Jetblack31/MaxPV/SchemasMaxPV/Schémas MAXPV 10x10 V2/Schema_ECOPV_10x10 V2_Logique.png

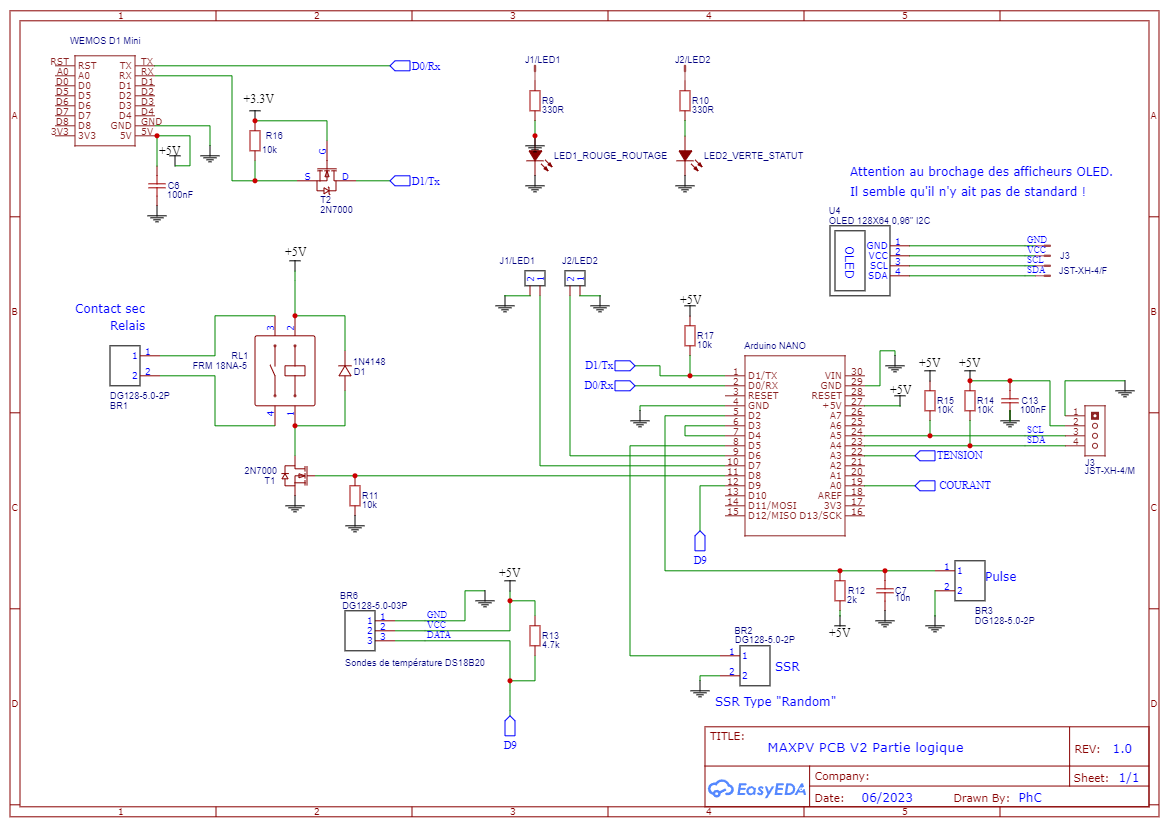
SchemasMaxPV/Schémas MAXPV 10x10 V2/Schema_ECOPV_10x10 V2_Logique.png
