Jetblack31/MaxPV/SchemasMaxPV/Schémas MAXPV 10x10 V2/Schematic_ECOPV_10x10 V2_Analogique.png

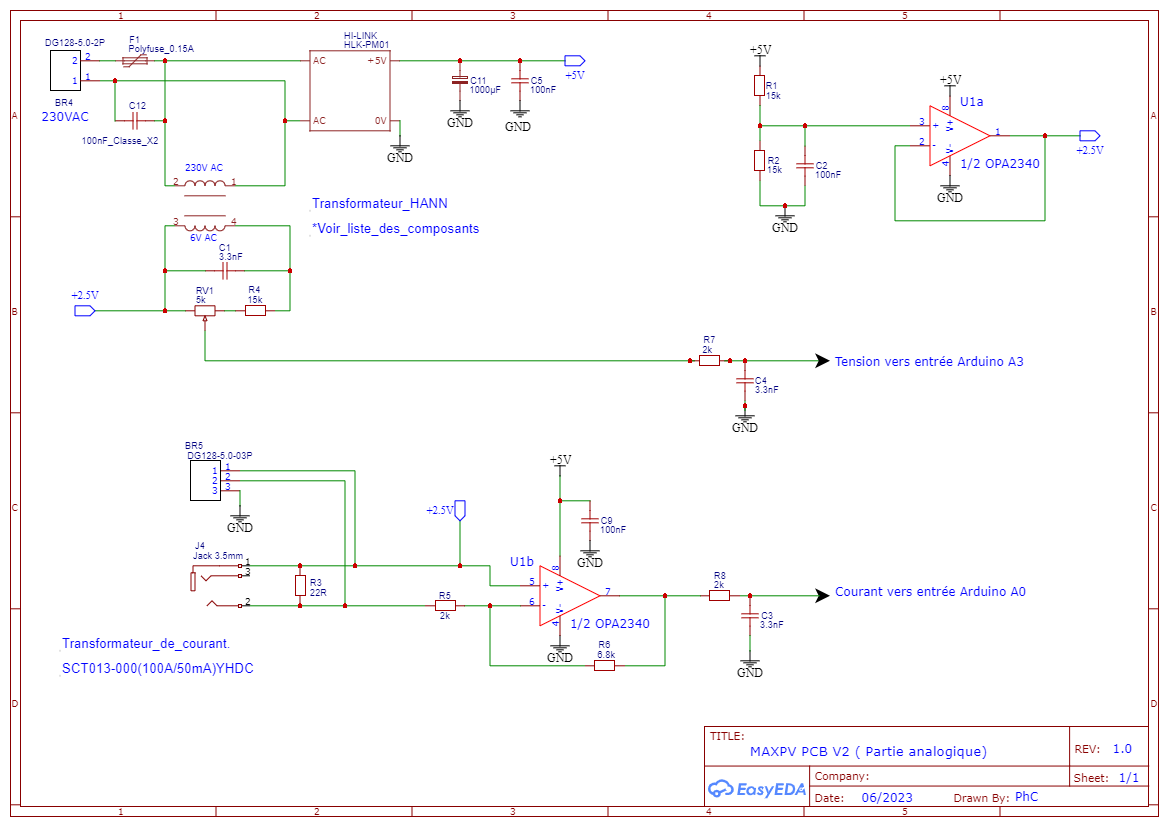
SchemasMaxPV/Schémas MAXPV 10x10 V2/Schematic_ECOPV_10x10 V2_Analogique.png
