Jetblack31/MaxPV/SchemasMaxPV/Schémas MaxPV DIN V2.2/Schema_MAXPV_DIN_Logique_V2.2.png

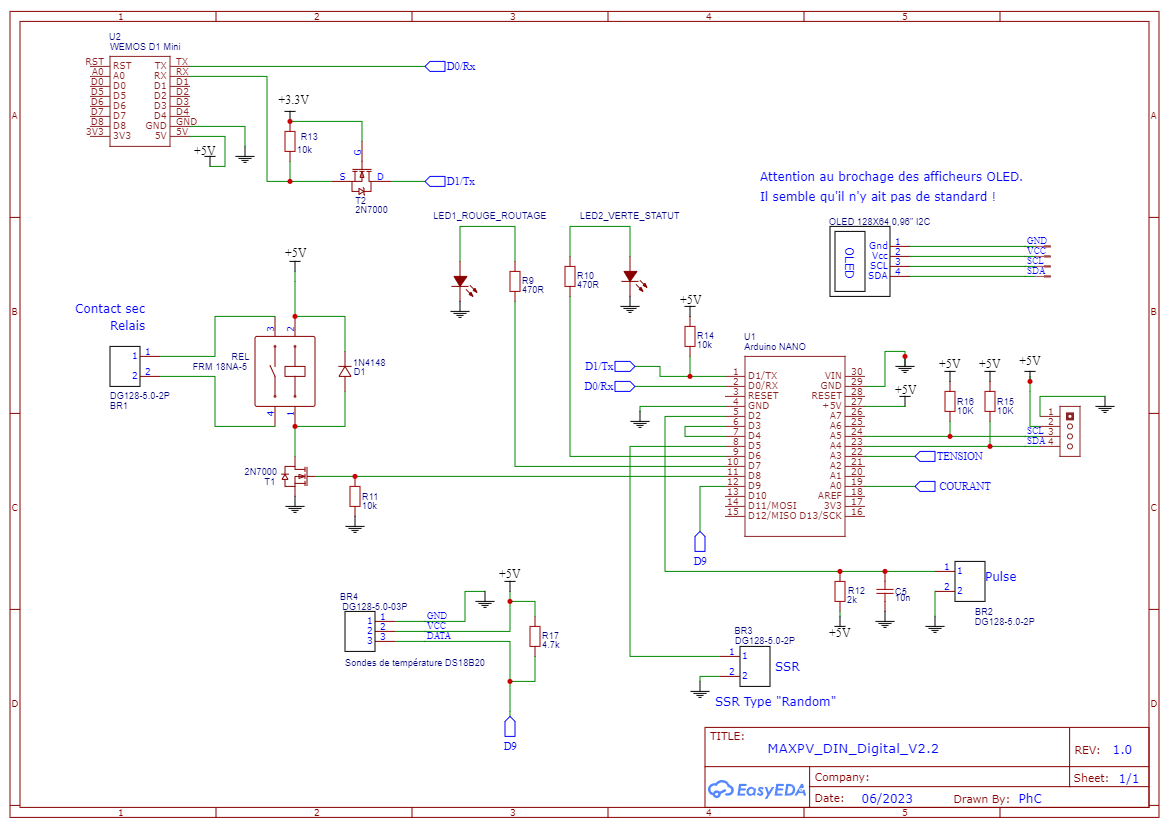
SchemasMaxPV/Schémas MaxPV DIN V2.2/Schema_MAXPV_DIN_Logique_V2.2.png
