Jetblack31/MaxPV/SchemasMaxPV/Schémas MaxPV DIN V2.2/Schematic_MAXPV_DIN_Analogique_V2_2023-07-07.png

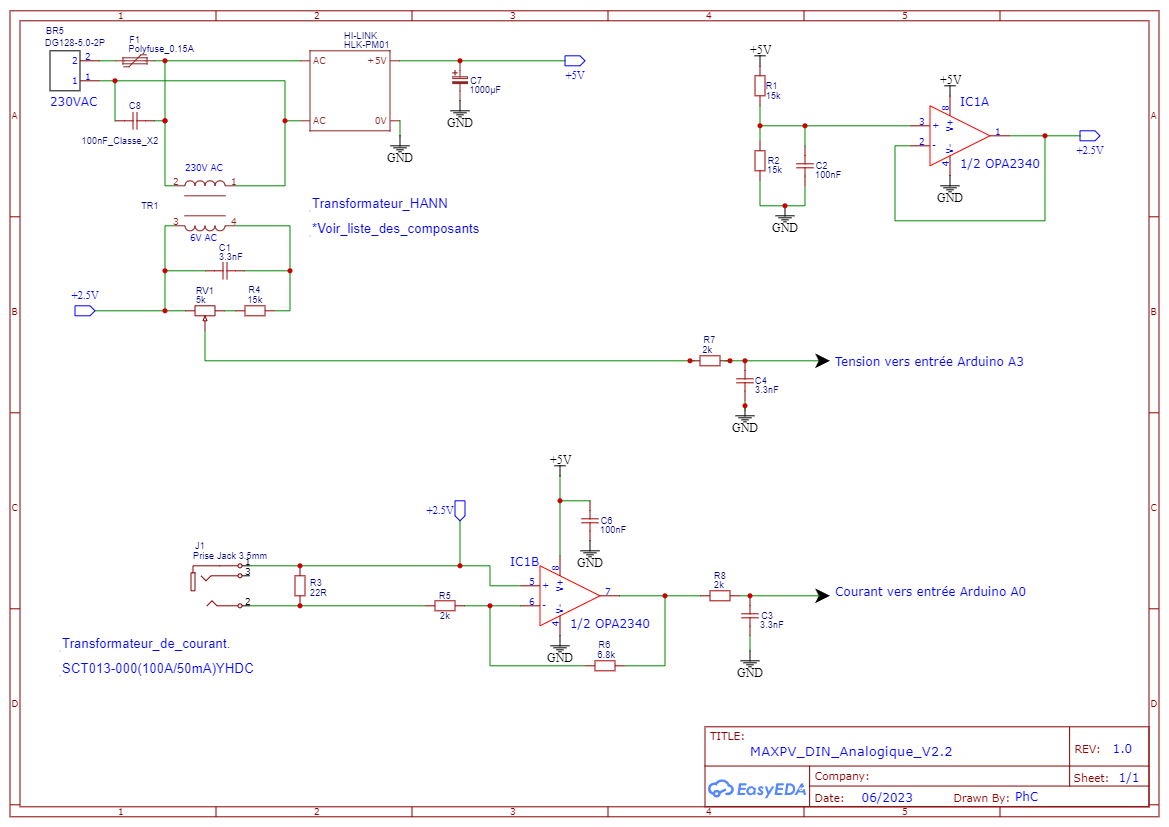
SchemasMaxPV/Schémas MaxPV DIN V2.2/Schematic_MAXPV_DIN_Analogique_V2_2023-07-07.png
