Jetblack31/MaxPV/(threads)

Thread 11 (2022-12-14):

Eviter l'activation du SSR par inadvertance

yoyolb, 2022-12-14:
Bonjour,

La page "Moniteur" présente des données de supervision ("Valeurs courantes") et permet également d'agir sur l'état du routeur (activation/désactivation du mode BOOST, activation du SSR, activation du relais).

Ces fonctionnalités sont très utiles mais il m'est arrivé à plusieurs reprises, en particulier sur un téléphone portable, de mettre en marche forcée le SSR par inadvertance en voulant seulement consulter les données de supervision.

Je pense qu'il serait judicieux de ce prémunir contre ces erreurs de manips:
- soit en séparant les données de supervision des actions de modification
- soit en ajoutant un popup de confirmation
- soit en ajoutant un mode "modification" versus "lecture seule" sur la page
- ... sans doute d'autres moyens ...

En tout cas merci pour le travail déjà réalisé, bravo !

Jetblack31, 2022-12-21:
Bonjour,

Merci pour le retour. Je vois comment modifier la présentation dans la nouvelle version pour régler ce problème.

Jetblack

Thread 13 (2023-01-19):

Comptabilisation routage en mode forcé

Stabu1, 2023-01-19:
Bonjour
Tout d’abord un grand bravo pour le travail formidable. Depuis la v3.5 la comptabilisation de la puissance routé inclue    la puissance consommée en mode forcé ce qui n’est pas logique. En version 3.35 ce n’était pas le cas, en mode forcé la nuit on ne peut pas considérer et comptabiliser un routage. Merci.

Jetblack31, 2023-01-19:
Bonsoir,

Merci pour le retour !
L'accumulation de l'énergie routée en mode FORCE ou BOOST était une demande de certains utilisateurs pour que le compteur d'énergie routée devienne un compteur d'énergie de production d'eau chaude.
D'où la modification en version 3.5.
Si vous voulez revenir au comportement initial, modifiez la ligne 690 du programme EcoPV en :

if ( triacMode == 9) routedEnergy += Prouted;

et uploadez le nano avec ce programme modifié.

Jetblack

Stabu1, 2023-01-20:
Merci pour la réponse et réactivité !
Je ferme l'issue.

Jetblack31, 2023-01-20:
Pour utiliser le #define du code, il serait plus "propre" d'utiliser

`if ( triacMode == AUTOM ) routedEnergy += Prouted;
`

Closed 2023-01-20.

Thread 22 (2024-04-03):

Ajout d'un minTemp ?

gmella, 2024-04-03:
Rajouter un **minTemp** pourrait permettre un fonctionnement autonome y compris en cas de mauvais temps prolongé ... du coup parfait pour l'hiver.
L'idéal étant de pouvoir monter un peu cette consigne lors des HC pour optimiser encore un peu, mais c'est moins important si l'installation est souvent en injection.

Merci pour ce superbe projet !

Thread 23 (2025-05-12):

Limite température basse CE et sortie contact sec ou boost

Mustang5705, 2025-05-12:
Bonjour,
Serait-il possible de déclencher le contact sec ou le mode boost sur une limite de température basse pour compléter le chauffage du CE dans la période HC (ou à définir) si les PV n'ont pas permis de chauffer suffisamment ?
Merci.
