Jetblack31/MaxPV/SchemasMaxPV/Schémas MaxPV DIN V2.2/Schematic_MAXPV_DIN_Analogique_V2_2023-07-07.pdf

## Transformateur_HANN

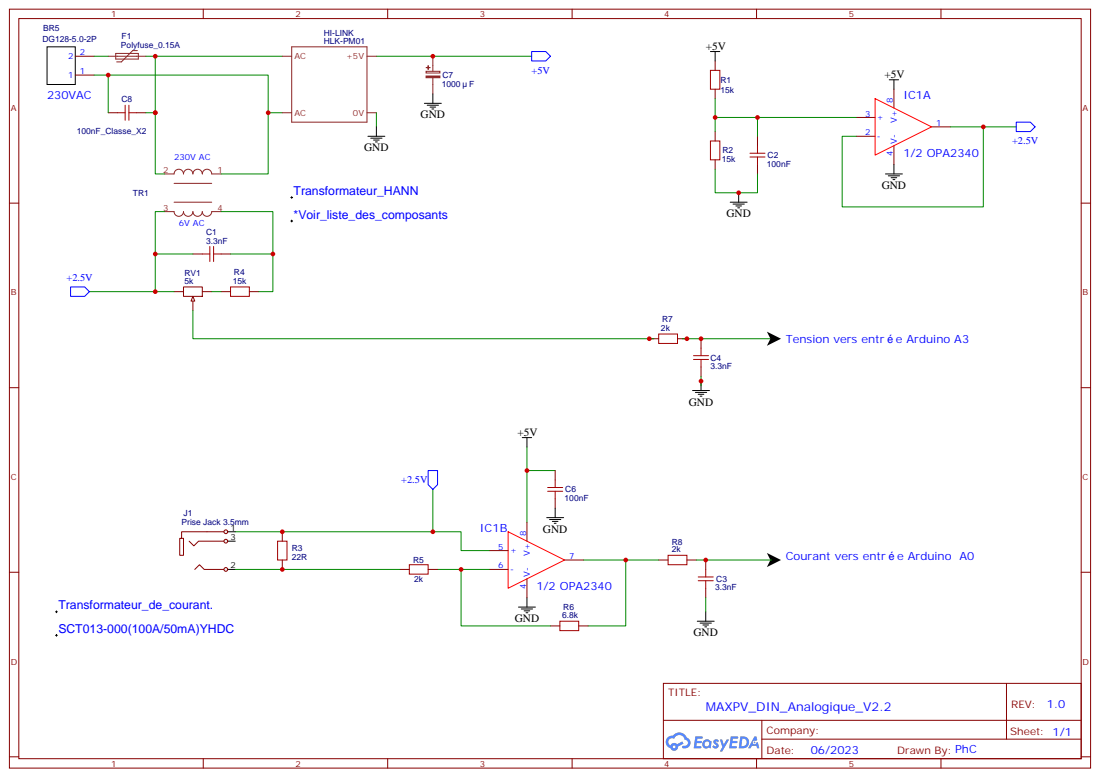
[picture p13: page 1]

Tension vers entr e Arduino A3

Courant vers entr e Arduino A0
