Jetblack31/MaxPV/SchemasMaxPV/Schémas MAXPV 10x10 V2/Schematic_ECOPV_10x10 V2_Analogique.pdf

## Transformateur_HANN

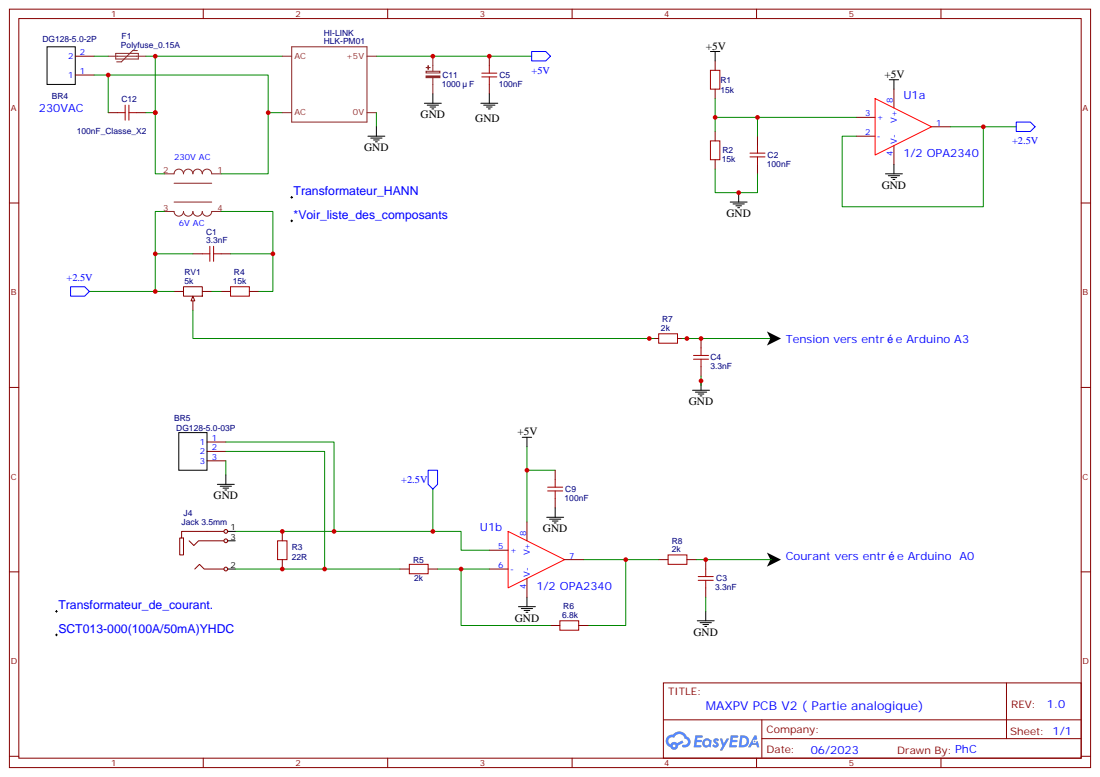
[picture p14: page 1]

Tension vers entr e Arduino A3

Courant vers entr e Arduino A0
