Jetblack31/MaxPV/SchemasMaxPV/Schémas MaxPV DIN V2.2/Schematic_MAXPV_DIN_Digital_V2.2_2023-07-07.pdf

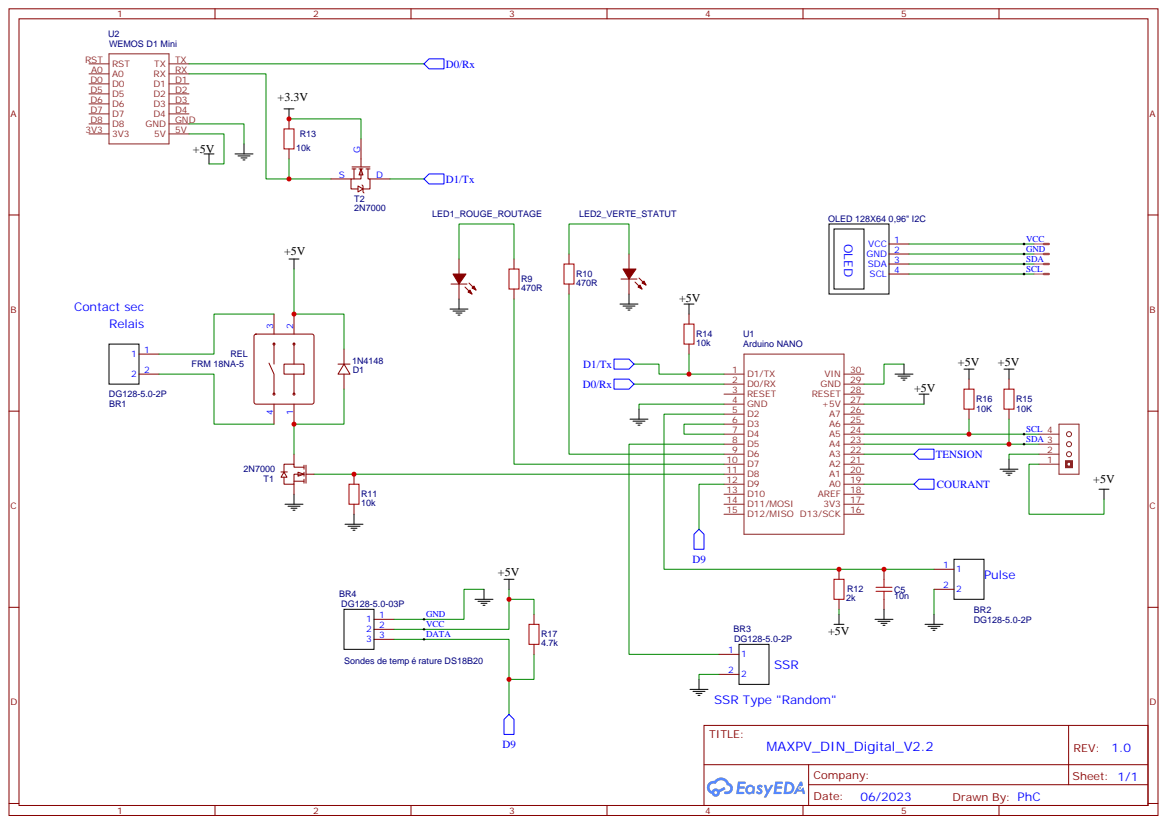
[picture p15: page 1]
