Jetblack31/MaxPV/SchemasMaxPV/Schémas MAXPV 10x10 V2/Schema_ECOPV_10x10 V2_Logique.pdf

## Il semble qu'il n'y ait pas de standard !

Attention au brochage des afficheurs OLED.

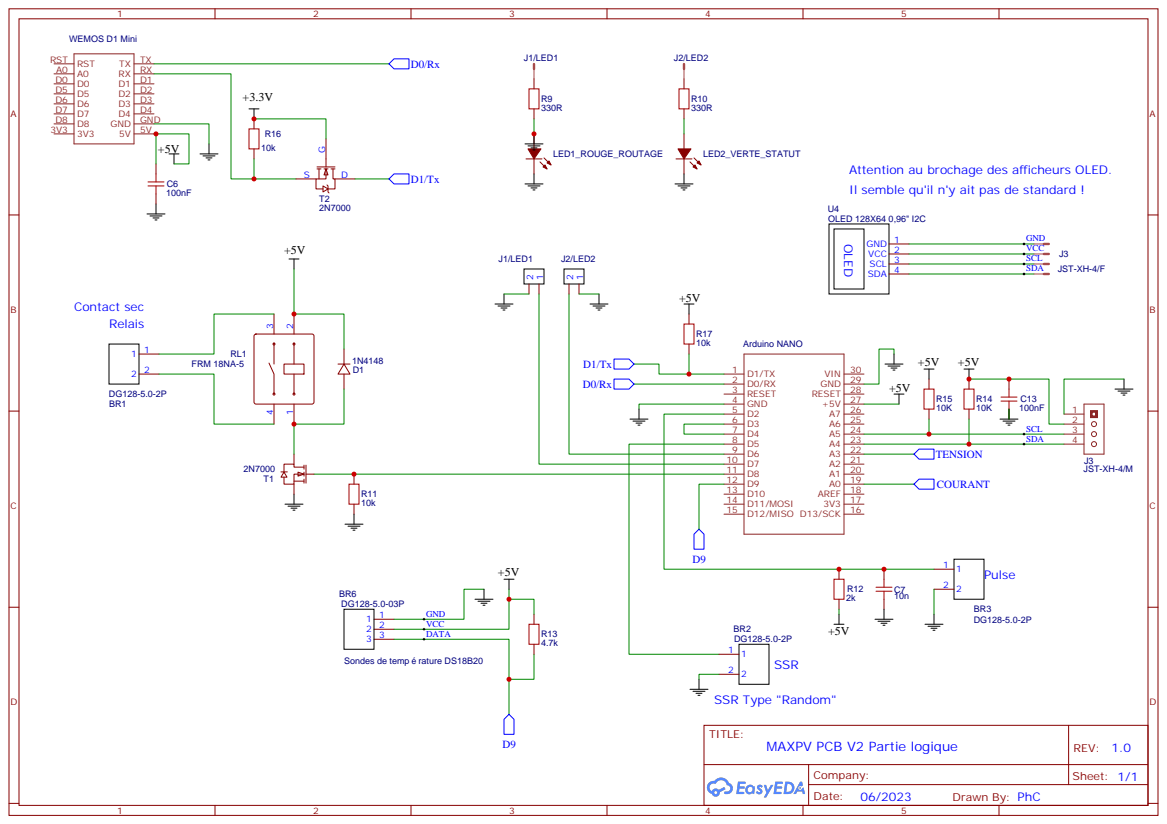
[picture p17: page 1]
