Jetblack31/MaxPV/SchemasMaxPV/Schémas MaxPV DIN V2.2/Schema_MAXPV_DIN_Logique_V2.2.pdf

Attention au brochage des afficheurs OLED.

## Il semble qu'il n'y ait pas de standard !

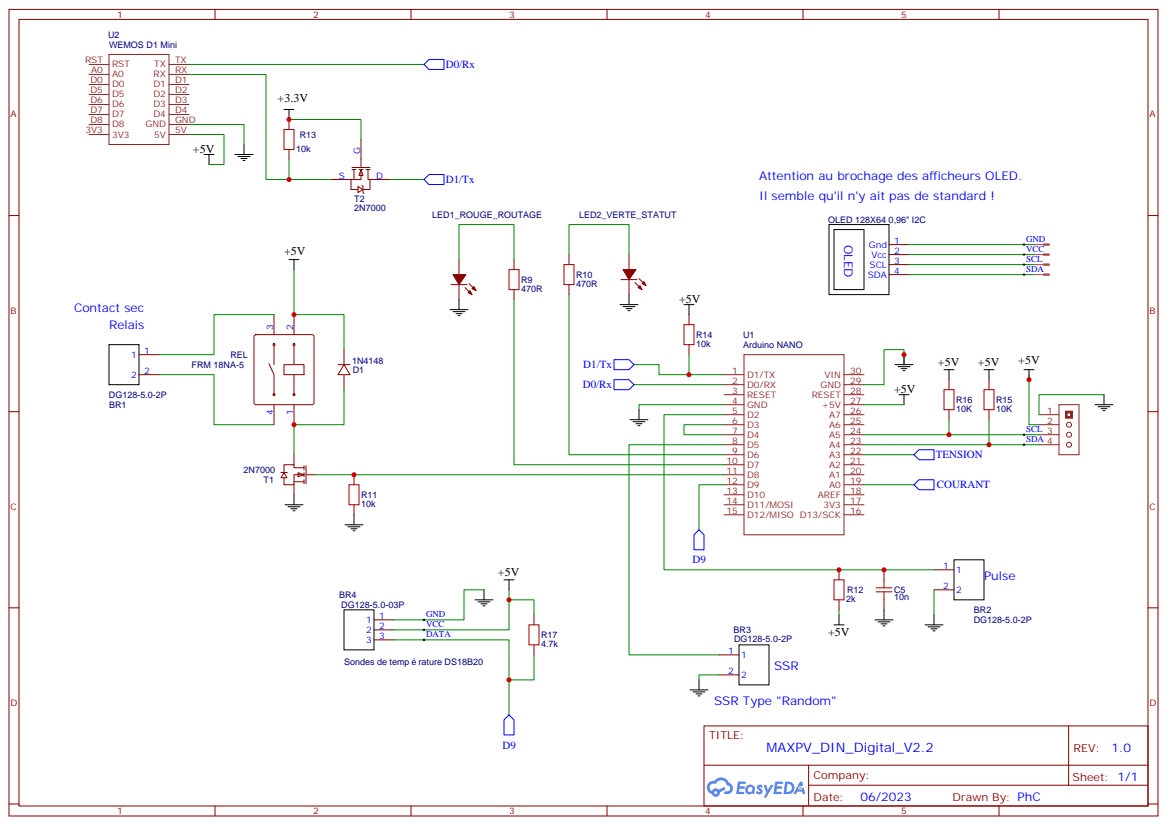
[picture p18: page 1]
