Jetblack31/MaxPV/(commit log)

2022-07-16 Update EcoPV3.ino
    Correction d'un Bug transitoire ON OFF ON lorsqu'on change le mode relais de FORCE à AUTO.
    [EcoPV3.ino]
2022-07-31 Version 3.0.1
    Correction d'un bug : passage du SSR du mode STOP au mode AUTO en régime de surplus de production
    Ajout de graphiques live
    Amélioration de la résolution de l'affichage des puissances
    [EcoPV3.ino, MaxPV3.ino]
2022-08-08 Version 3.0.2
    EcoPV : amélioration du traitement série
    MaxPV : pas de changement
    Site Web : ajout de la vérification de la version, ajout d'un bargraph pour le réglage de PHASE_CAL, optimisation des pages
2022-08-13 Versio 3.1
    EcoPV : corrections mineures
    MaxPV! : ajout de l'historique des puissances sur 96h par pas de 30 minutes
    [EcoPV3.ino, MaxPV3.ino]
2022-10-23 Amélioration du comptage des impulsions externes
2022-11-05 Version 3.31
    MQTT complété et authentifié
    Mode BOOST programmation horaire
    Correction de bugs (restauration configuration)
    [EcoPV3.ino, MaxPV3.ino]
2022-11-06 Ajout des actions sur réception de messages MQTT
2022-11-07 Update configuration.html
    Ajout des descriptions succintes des paramètres de configuration
2022-11-08 Update configuration.html
    Modification des entêtes de cellules pour afficher seulement les paramètres en gras :
    Modification des <th> (style par défaut gras) en <td> (style par défaut normal) et ajout de balise bold <b> sur le paramètre
2022-11-08 Envoi MQTT sur changement d'état SSR et Relay
2022-11-11 Update admin.html
    Correction mineure de la sauvegarde de la configuration
2022-11-13 Correction MQTT Discovery pour I_RMS
    [MaxPV3.ino]
2022-11-16 Modification du thème (version code couleur de github)
    Ajustement de quelques élements pour un style proche du code couleur du dark theme de github
2022-11-17 Mise à jour thème sombre
    Ajustement des couleurs selon palette apple dark mode :
    https://www.color-hex.com/color-palette/99159
2022-11-17 Modification couleur graphe Facteur de puissance
    Modification de la couleur de ligne du graphe Facteur de puissance :
    - couleur noire (#000000) remplacée par gris (#818181) pour compatibilité avec le thème sombre
2022-11-20 Ajout des state_class et correction des unités
    [MaxPV3.ino]
2022-11-20 Noms des binaires
2022-11-20 Renommage des binaires avec pio
2022-11-20 Ajustement des noms de binaires
2023-01-15 Correction SN par défaut
    [maxpv_defines.h]
2023-01-21 V 3.51
    Prise en compte de l'énergie routée en mode FORCE selon une option de compilation du programme Arduino Nano
    Amélioration de la gestion de l'écran Oled.
    Correction d'un effet de bord en cas de demande de redémarrage de l'Arduino Nano.
    Amélioration du site Web. Retour d'état des boutons en page d'accueil.
    L'absence de réponse de l'Arduino Nano n'est plus bloquante pour le démarrage du Wemos et du site Web.
    Corrections diverses.
    [EcoPV3.ino, MaxPV3.ino, maxpv_defines.h]
2023-01-28 HA durée de fonctionnement du relais
    Ajout du topic MQTT durée de fonctionnement du relais
2023-02-17 Update EcoPV3.ino
    Correction affichage oLed
    Correction bug mise à 0 index temps fonctionnement du relais
    [EcoPV3.ino]
2023-03-05 Version 3.55
    Correction d'un bug de fonctionnement du relais secondaire
    Possibilité de configurer le mode par défaut SSR et relais secondaire
    Mise à jour de la documentation
    [EcoPV3.ino, maxpv_options.h]
2023-03-19 V3.57 initiale
    Mode Relay Plus,
    Correction bug EcoPV
    [EcoPV3.ino, MaxPV3.ino, maxpv_defines.h]
2023-06-11 Version 3.57
    Fonction RelayPlus
    Correction bug année 1970
    Amélioration de la détection de la deconnexion de la charge SSR
    [EcoPV3.ino, MaxPV3.ino, maxpv_defines.h]
2023-07-08 Mise à jour des schémas électroniques
2023-11-01 Mise à jour des schémas
2023-11-03 Version 3.58
    Ajout des topics Puissance importée et Puissance exportée à MQTT
2024-01-27 Version 3.59
    * Utilisation de l'heure de Paris au lieu de l'heure solaire. Passage heure été / hiver automatique.
    * Zoom dans le graphe historique.
    * Correction bug mineur MQTT.
    * Préparation de la prise en charge de la sonde de température ECS !! pas encore fonctionnel !!.
    [MaxPV3.ino, maxpv_defines.h]
2024-02-03 V 3.60
    Prise en charge de la mesure de température.
    Limitation du BOOST sur température ECS.
2024-02-04 Version 3.61
    Prise en charge de la sonde de température ECS en MQTT
2024-08-31 Changement de librairie ElegantOTA
2024-08-31 Mise à jour des images
2025-04-06 Passage en site Web 3.61
    Longueur des champs URL relais distants augmentés à 127 caractères au lieu de 63
2026-05-16 Version 3.63
    Correction des sources script pour affichage des graphiques.
