Jetblack31/MaxPV/(notices)

Notices in the files:
MaxPV3/MaxPV3.ino:
This program is free software: you can redistribute it and/or modify
it under the terms of the GNU Lesser General Public License as published
